ghostinkoma/water_boarder/hardware/WaterBorder.kicad_sch

## KiCad design hardware/WaterBorder.kicad_sch (2026-07-23)

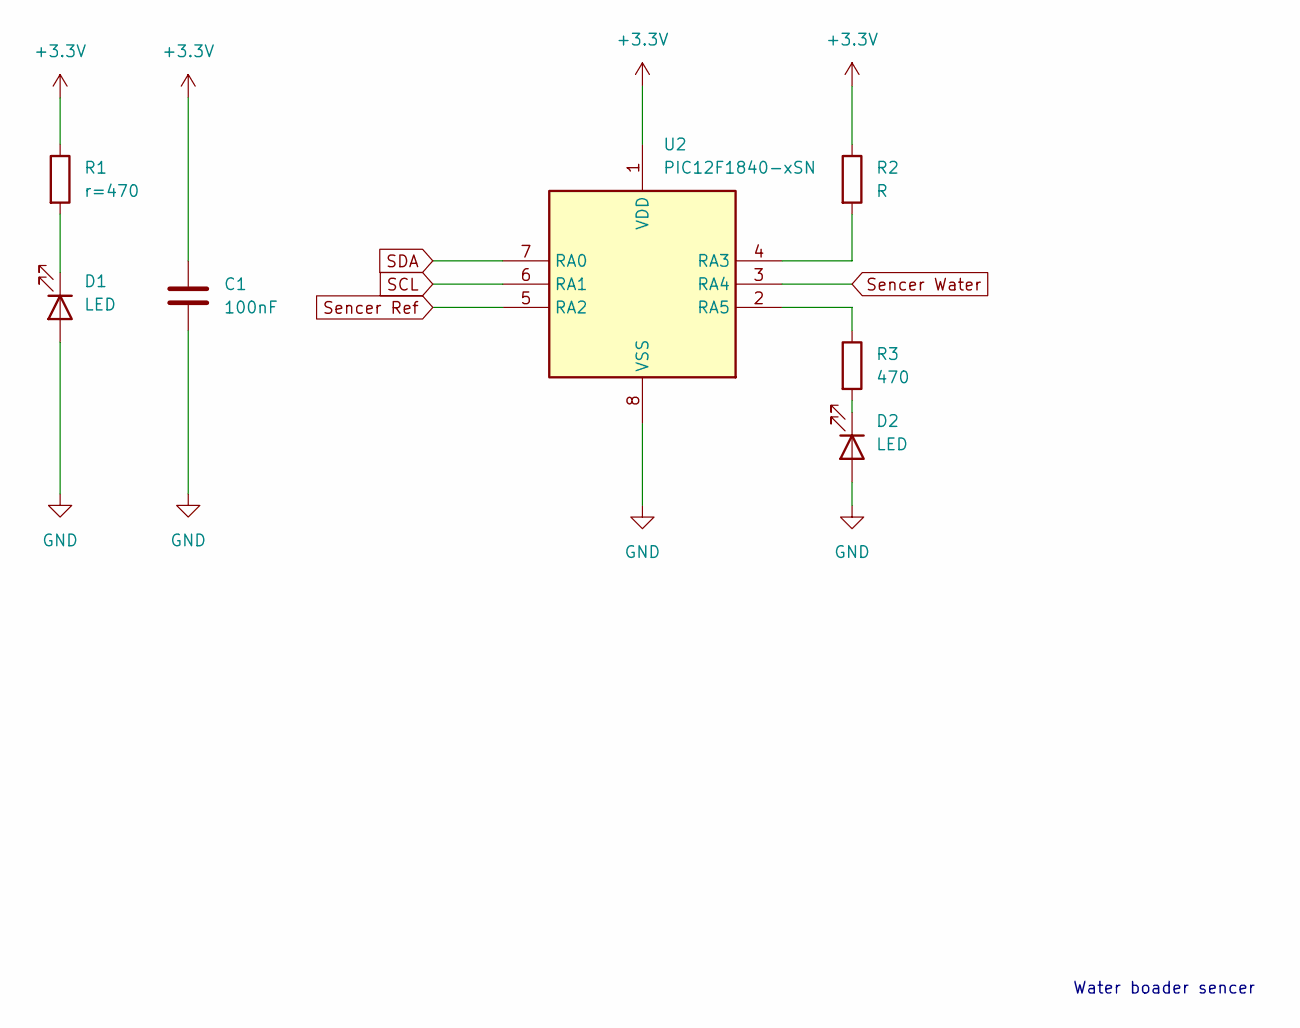
[picture p1: schematic WaterBorder.kicad_sch]

Parts:
C1: 100nF
D1, D2: LED
R1: r=470
R2: R
R3: 470
U2: PIC12F1840-xSN; SOIC-8_3.9x4.9mm_P1.27mm

Connections:
+3.3V: C1.1, R1.1, R2.1, U2.1 (VDD)
GND: C1.2, D1.2 (A), D2.2 (A), U2.8 (VSS)
unnamed: D1.1 (K), R1.2
unnamed: D2.1 (K), R3.2
unnamed: R2.2, U2.4 (RA3)
unnamed: R3.1, U2.2 (RA5)
SCL: U2.6 (RA1)
SDA: U2.7 (RA0)
Sencer Ref: U2.5 (RA2)
Sencer Water: U2.3 (RA4)

Notes on the sheet:
Water boader sencer
