ghostinkoma/water_boarder/(commit log)

2026-07-23 chore: WaterBoader をスタンドアロン ライブラリ repo として初期化
    PIC12F1840 非接触静電容量式(CPS)水位センサ(I2Cスレーブ0x20)の実機完成資産を
    D:\hobby\water_boarder\PIC12F18XX から標準ライブラリ構成へ集約:
    - src/ Arduino/ESP32 ライブラリ本体 (WaterBoader.h/.cpp)
    - examples/ WaterBoaderDemo
    - firmware/ 確定PICファーム i2c_wb_5V.c / i2c_wb_3V3.c / gen_3v3.sh
    - docs/ SPEC.md + ライブラリ切出し引き継ぎDISPATCH
    - hardware/ KiCad 回路/基板
    - library.properties / library.json (PlatformIO) / LICENSE(MIT) / .gitignore
    [WaterBoader.kicad_pcb, WaterBoader.kicad_sch]
2026-07-23 fix(hardware): 空スタブKiCadを実体の回路図 WaterBorder.kicad_sch に差替え
    初期コミットで誤って空テンプレート(sch 133B/pcb 78B/pro 584B)を同梱していた。
    実設計は PIC12F18XX 直下の WaterBorder.kicad_sch(37KB, 2026-07-22編集)。
    PCBは未作成(autosaveのみ)のため回路図のみ同梱。ファイル名は内部参照保護のため原名維持。
    [WaterBoader.kicad_pcb, WaterBoader.kicad_sch, WaterBorder.kicad_sch]
2026-07-23 refactor(firmware): 5V/3.3V を独立MPLAB Xプロジェクト化
    - 旧フラット firmware/i2c_wb_5V.c / i2c_wb_3V3.c を削除
    - MPLAB X プロジェクト i2c_wb_5V.X / i2c_wb_3V3.X を配備 (ターゲット PIC12F1840)
    - 差は main.c の #define TEMP_HIGH_RANGE (5V=1 / 3.3V=0) の1行のみ
    - .gitignore に MPLAB X 生成物(build/dist/debug)nbproject/privateMakefile-local を追加
2026-07-23 docs: 日本語ドキュメント群を追加 (README.ja + docs/ja/ 一式)
    - README.ja.md: 日本語トップ + ドキュメント地図
    - docs/ja/install.md: 初心者向け構築ガイド(ツール/書込/配線/初回起動)
    - docs/ja/hardware.md: 配線図電極BOM電圧
    - docs/ja/usage.md: 校正/読取/EEPROM自律/故障復帰/EMI/温度
    - docs/ja/api.md: APIレジスタ早見温度校正式
    - docs/ja/troubleshooting.md: 症状対処
    - README.md 先頭に言語リンク追加
